DominicHolmes/koffing/(commit log)

2026-03-21 Add WiFi/MQTT reporting and server stack (Phase 2)
    ESP32 publishes sensor data as JSON over MQTT every 5s. Server stack
    (Mosquitto, Telegraf, InfluxDB 3, Grafana) with Brewfile, setup/teardown
    scripts, and provisioned Grafana dashboard. All credentials templated
    via secrets.h (gitignored).
2026-03-21 Add MiCS5524 gas sensor, fix server setup token handling
    Integrate MiCS-5524 analog gas sensor on A0 with 3-min warmup, WiFi
    disconnect overlay, and improved OLED error states. Fix InfluxDB token
    parsing to strip ANSI codes, persist token to file for idempotent
    setup reruns, and show .local hostname in setup output.
    [koffing.ino]
2026-03-22 Combine all sensors into air quality level for Koffing sprite
    Previously only PM2.5 drove the sprite face and cloud count.
    Now CO2, VOC, and gas (MiCS5524) each have their own level mapping,
    and the worst reading wins — any single bad sensor triggers the visual.
    Also adds README photos of the OLED display and breadboard.
2026-03-24 Add VBUS tracking and SCD40 failure diagnostics
    - Add VBUS voltage panel to Grafana dashboard
    - Implement SCD4x retry logic and improved timeout handling in firmware
    - Add detailed diagnosis of the 16:08 'Electrical Event' to debugging log
    - Add official factory test script for SCD40 hardware validation
    [koffing.ino, scd40_factory_test.ino]
